Wetmelon/DifferentialSPIEncoder/Master/ODrive_Mech.PNG

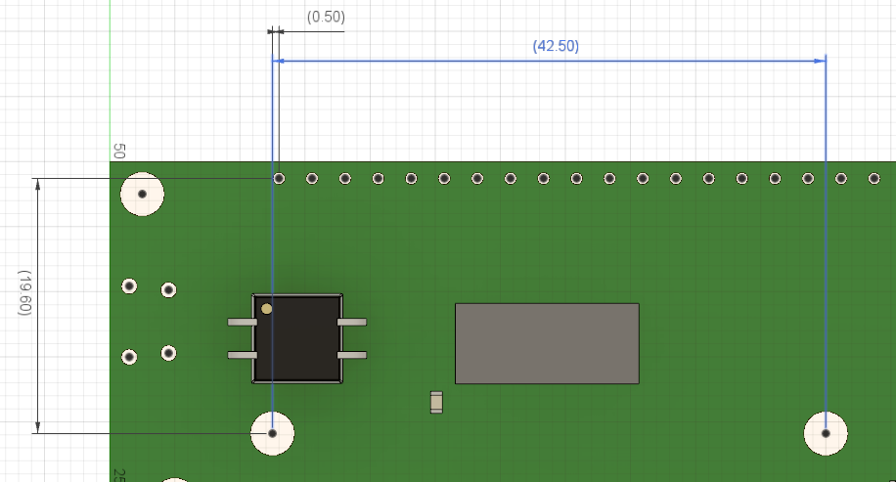
Master/ODrive_Mech.PNG
