Wetmelon/DifferentialSPIEncoder/MOUSER_BOM.xlsx

Source: | /DifferentialSPIEncoder/Master/DifferentialSPIMaster.sch
Date: | 2019
Tool: | Eeschema (5.1.4-0)
Generator: | bom_csv_grouped_by_value.py
 |  |  | MASTER
Item | Qty | Reference(s) | Value | LibPart | Footprint | Datasheet | MANUFACTURER | MFN
1 | 6 | C1, C4, C6, C7, C8, C9 | 100nF | Device:C | Capacitor_SMD:C_0805_2012Metric_Pad1.15x1.40mm_HandSolder | https://www.mouser.com/ProductDetail/KEMET/C0805C104K8RACTU | KEMET | C0805C104K8RACTU
2 | 5 | C2, C3, C5, C10, C11 | 2.2pF | Device:C | Capacitor_SMD:C_0805_2012Metric_Pad1.15x1.40mm_HandSolder | https://www.mouser.com/ProductDetail/KEMET/C0805C229C5GACTU?qs=sGAEpiMZZMs0AnBnWHyRQOf5HOpVaXbhFR3RVpI2kPg%3D | KEMET | C0805C229C5GACTU
3 | 2 | H1, H2 | MountingHole | Mechanical:MountingHole | MountingHole:MountingHole_3.5mm
4 | 2 | J1, J3 | Motor Encoder 0 | Connector:8P8C_Shielded | Connector_RJ:RJ45_Amphenol_RJHSE5380 | https://www.mouser.com/ProductDetail/Amphenol-Commercial-Products/RJHSE-5380?qs=rM3ofmSYd5RUaPrWD7oMhw%3D%3D | Amphenol Commercial Products | RJHSE5380
5 | 1 | J2 | Conn_01x20 | Connector_Generic:Conn_01x20 | Connector_PinHeader_2.54mm:PinHeader_1x20_P2.54mm_Vertical
6 | 1 | NT1 | Net-Tie_2 | Device:Net-Tie_2 | NetTie:NetTie-2_SMD_Pad0.5mm
7 | 2 | R1, R13 | 120 | Device:R_Small | Resistor_SMD:R_0805_2012Metric_Pad1.15x1.40mm_HandSolder | https://www.mouser.com/ProductDetail/Yageo/AC0805JR-07120RL?qs=sGAEpiMZZMu61qfTUdNhG2gsBIEdmNID0VVuxMUL8GE%3D | Yageo | AC0805JR-07120RL
8 | 12 | R2, R3, R4, R5, R6, R7, R8, R9, R10, R11, R12, R14 | 1k | Device:R | Resistor_SMD:R_0805_2012Metric_Pad1.15x1.40mm_HandSolder | https://www.mouser.com/ProductDetail/Yageo/AC0805FR-7W1KL | Yageo | AC0805FR-7W1KL
9 | 6 | U1, U2, U3, U4, U5, U6 | MAX485E | Interface_UART:MAX485E | Package_SO:SOIC-8_3.9x4.9mm_P1.27mm | https://www.mouser.com/ProductDetail/Maxim-Integrated/MAX485ESA%2b | Maxim Integrated | MAX485ESA+
 | 37
 |  |  | SLAVE
Item | Qty | Reference(s) | Value | LibPart | Footprint | Datasheet | MANUFACTURER | MFN
1 | 1 | C1 | 10uF | Device:C | Capacitor_SMD:C_0603_1608Metric | https://www.mouser.com/ProductDetail/KEMET/C0603C106M8PACTU | KEMET | C0603C106M8PACTU
2 | 4 | C3, C7, C8, C9 | 100nF | Device:C | Capacitor_SMD:C_0402_1005Metric | https://www.mouser.com/ProductDetail/KEMET/C0402C104K8PAC7411 | KEMET | C0402C104K8PAC7411
3 | 3 | C4, C5, C6 | 2.2pF | Device:C | Capacitor_SMD:C_0402_1005Metric | https://www.mouser.com/ProductDetail/KEMET/C0402C229C8GACTU?qs=sGAEpiMZZMs0AnBnWHyRQG8EQLxJcrqdhsIEzL7CC1E%3D | KEMET | C0402C229C8GACTU
4 | 1 | J1 | Conn_01x05_Male | Connector:Conn_01x05_Male | Connector_PinHeader_2.54mm:PinHeader_1x05_P2.54mm_Vertical
5 | 1 | J2 | 8P8C_Shielded | Connector:8P8C_Shielded | Connector_RJ:RJ45_Amphenol_RJHSE5380 | https://www.mouser.com/ProductDetail/Amphenol-Commercial-Products/RJHSE-5380?qs=rM3ofmSYd5RUaPrWD7oMhw%3D%3D |  | RJHSE5380
6 | 5 | R1, R5, R6, R7, R8 | 10k | Device:R | Resistor_SMD:R_0402_1005Metric | https://www.mouser.com/ProductDetail/Yageo/RT0402DRE0710KL | Yageo | RT0402DRE0710KL
7 | 3 | R2, R3, R4 | 1k | Device:R | Resistor_SMD:R_0402_1005Metric | https://www.mouser.com/ProductDetail/Yageo/AA0402FR-071KL | Yageo | AA0402FR-071KL
8 | 2 | R9, R10 | 120 | Device:R_Small | Resistor_SMD:R_0402_1005Metric | https://www.mouser.com/ProductDetail/Yageo/RC0402JR-07120RL | Yageo | RC0402JR-07120RL
9 | 1 | U2 | AS5048A | Sensor_Magnetic:AS5048A | Package_SO:TSSOP-14_4.4x5mm_P0.65mm | https://www.mouser.com/ProductDetail/ams/AS5048A-HTSP-500?qs=sGAEpiMZZMsDsvR9Yj%2Fex3rI8ueL6AI9 | ams | AS5048A-HTSP-500
10 | 3 | U3, U4, U5 | MAX485E | Interface_UART:MAX485E | Package_SO:SOIC-8_3.9x4.9mm_P1.27mm | https://www.mouser.com/ProductDetail/Maxim-Integrated/MAX485ESA%2b |  | MAX485ESA+
 | 24
