Wetmelon/DifferentialSPIEncoder/Slave/3dmodels/SM02B-GHS-TB.STEP

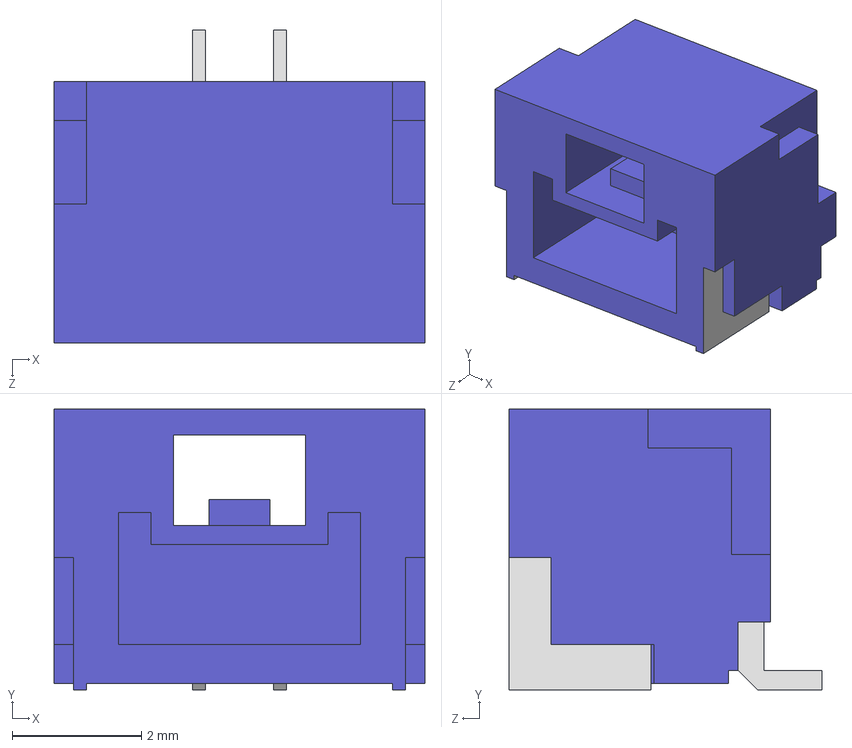
[picture p2: CAD file, 2022-04-24]
Slave/3dmodels/SM02B-GHS-TB.STEP
5.75 x 4.35 x 4.85 mm
