Wetmelon/DifferentialSPIEncoder/Slave/DifferentialEncoderSlave.step

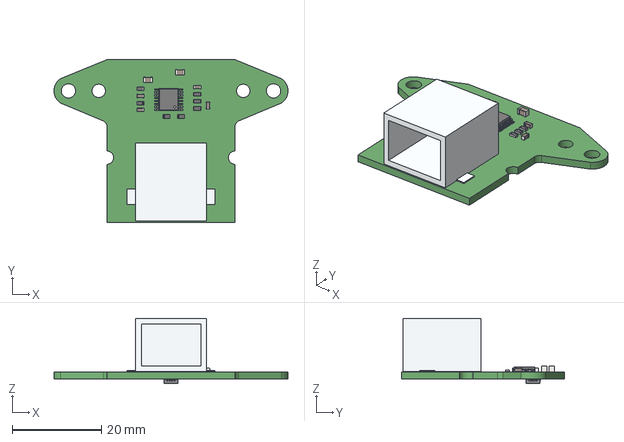
[picture p3: CAD file, 2020-12-17]
Slave/DifferentialEncoderSlave.step
52.5 x 36.5 x 14.6 mm
