Wetmelon/DifferentialSPIEncoder/Slave/RJLSE4x1xx.STEP

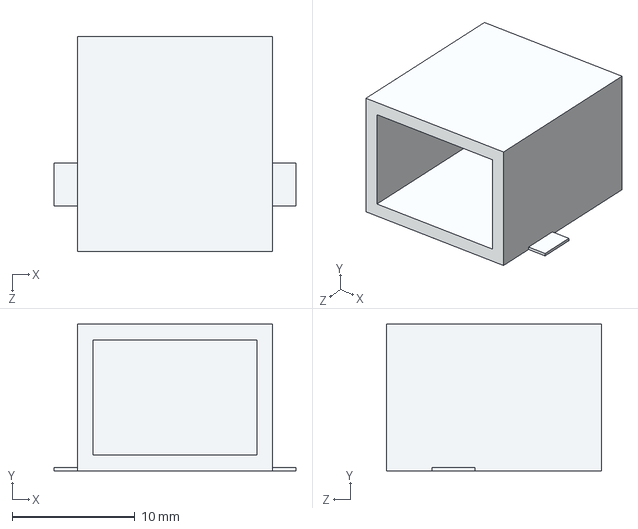
[picture p4: CAD file, 2020-12-06]
Slave/RJLSE4x1xx.STEP
19.7 x 11.9 x 17.5 mm
