Wetmelon/DifferentialSPIEncoder/Slave/3dmodels/5025850670.stp

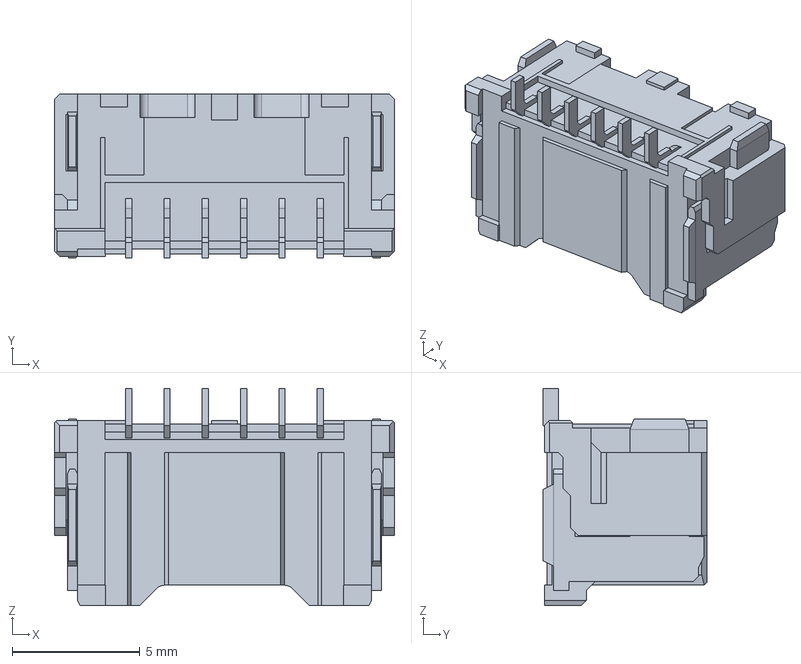
[picture p5: CAD file, 2022-04-24]
Slave/3dmodels/5025850670.stp
13.3 x 6.40 x 8.50 mm
