Wetmelon/DifferentialSPIEncoder/(list of files, cad)

Other CAD files:
Slave/RJLSE4x1xx.SLDPRT
Slave/Solidworks/DifferentialEncoderSlave.SLDASM
