Wetmelon/DifferentialSPIEncoder/(threads)

Thread 1 (2019-11-26):

Recommendation: label top of master with pin names of odrive board

owhite, 2019-11-26:
...because the master gets stuck on top of the odrive, it's hard to read the already difficult to read pin names of the odrive header. Labels on the master would be helpful in next version.

Thread 2 (2019-12-02):

Changes for Rev 2

Wetmelon, 2019-12-02:
- [ ] Connect PWM to debug header
- [ ] Use RJ45 LEDs for pwr & etc
- [ ] Termination resistor on both ends, not just 1 end
- [ ] Add pullup resistor to CS
- [ ] General CS handling logic review
- [ ] Disconnect pins 6-10 on AS5048A, leave pin 5 on GND
- [ ] Add AMT102 "Wide" compatible holes
- [ ] Add debug output on slave header for MOSI
- [ ] 10MHz transceivers
