Wetmelon/DifferentialSPIEncoder/Master/DifferentialEncoderMaster.pdf

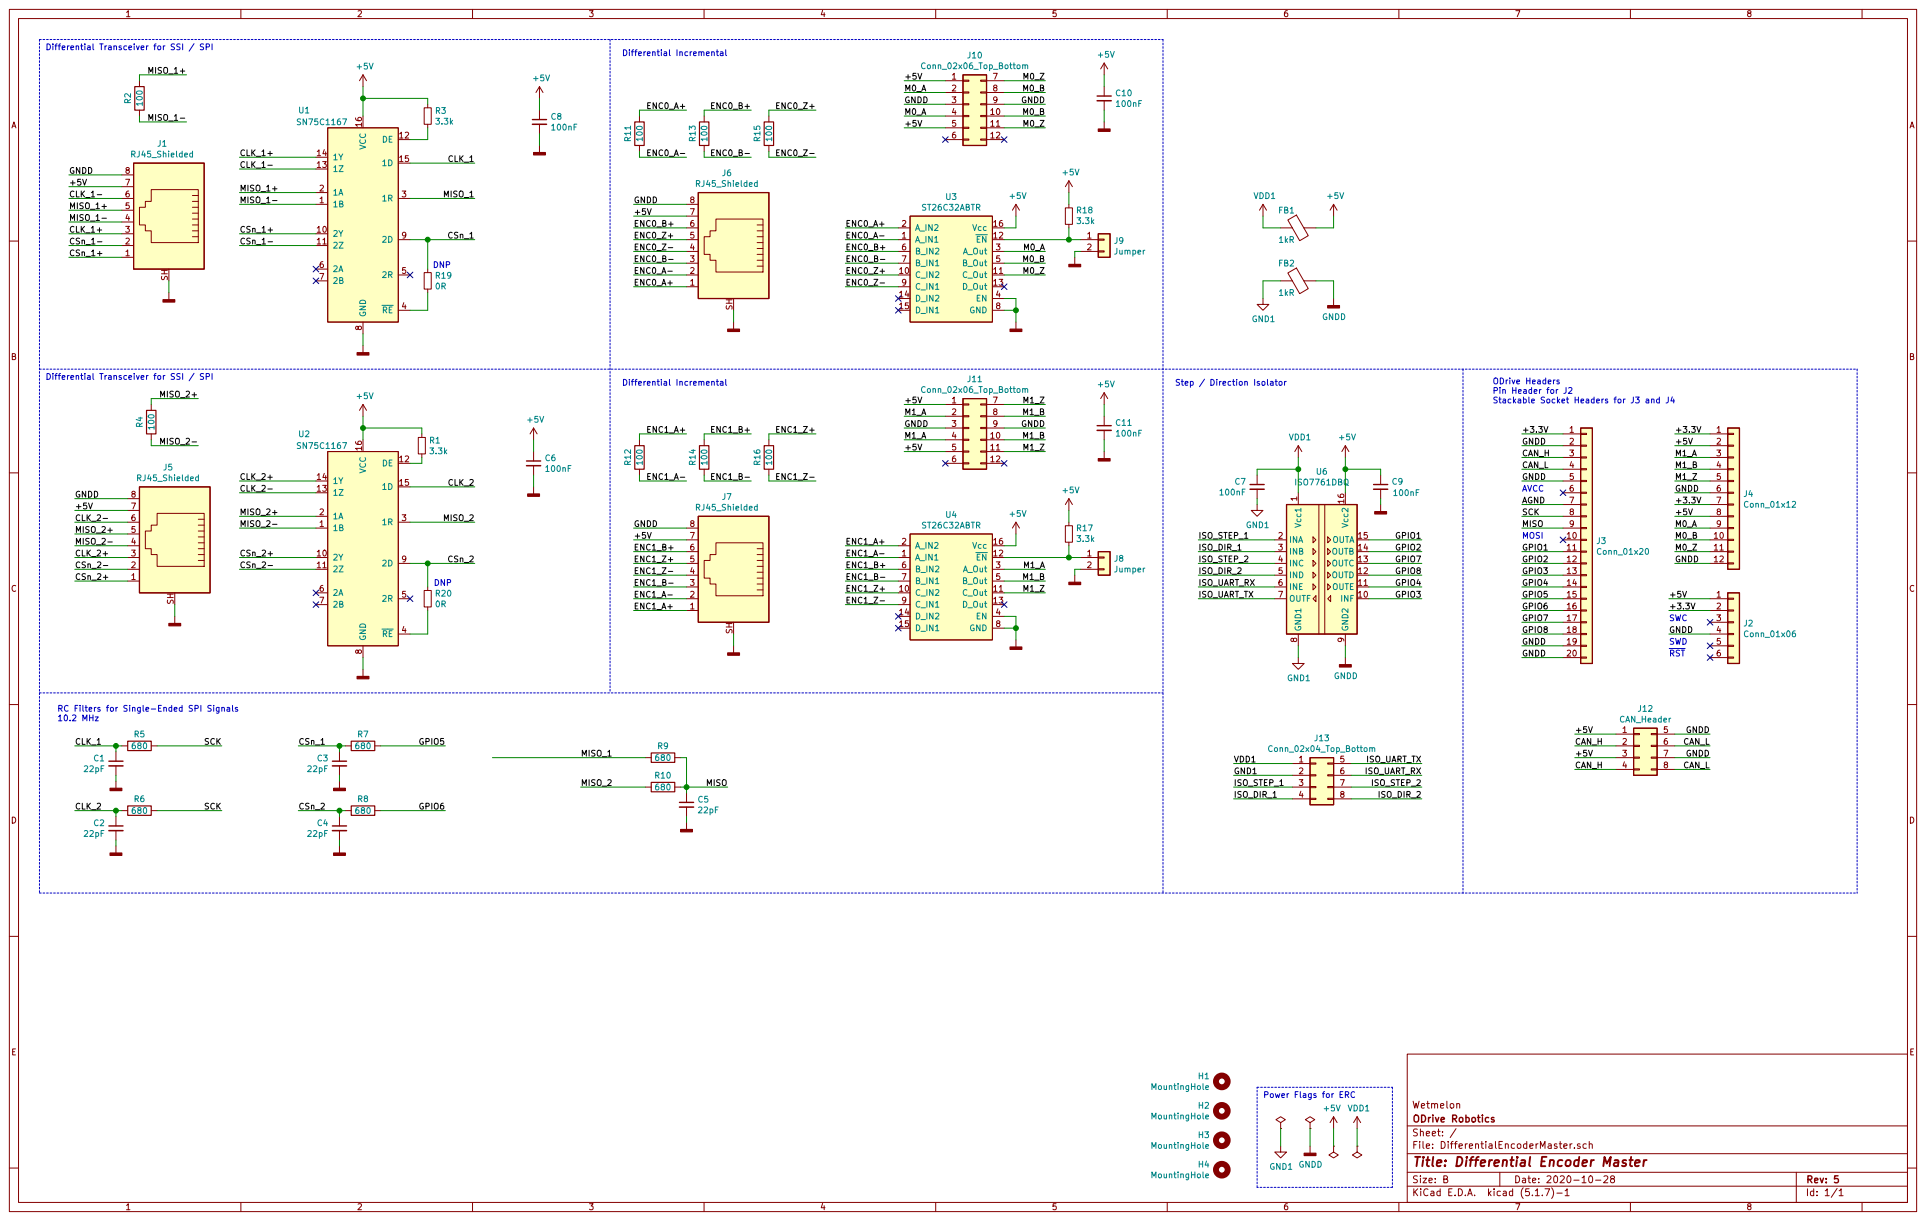
[picture p6: page 1]

Power Flags for ERC
VDD1 GND1

Id: 1/1 Title: Differential Encoder Master File: DifferentialEncoderMaster.sch Sheet: / ODrive Robotics Wetmelon
