Wetmelon/DifferentialSPIEncoder/Master/Isolated DifferentialEncoderMaster.pdf

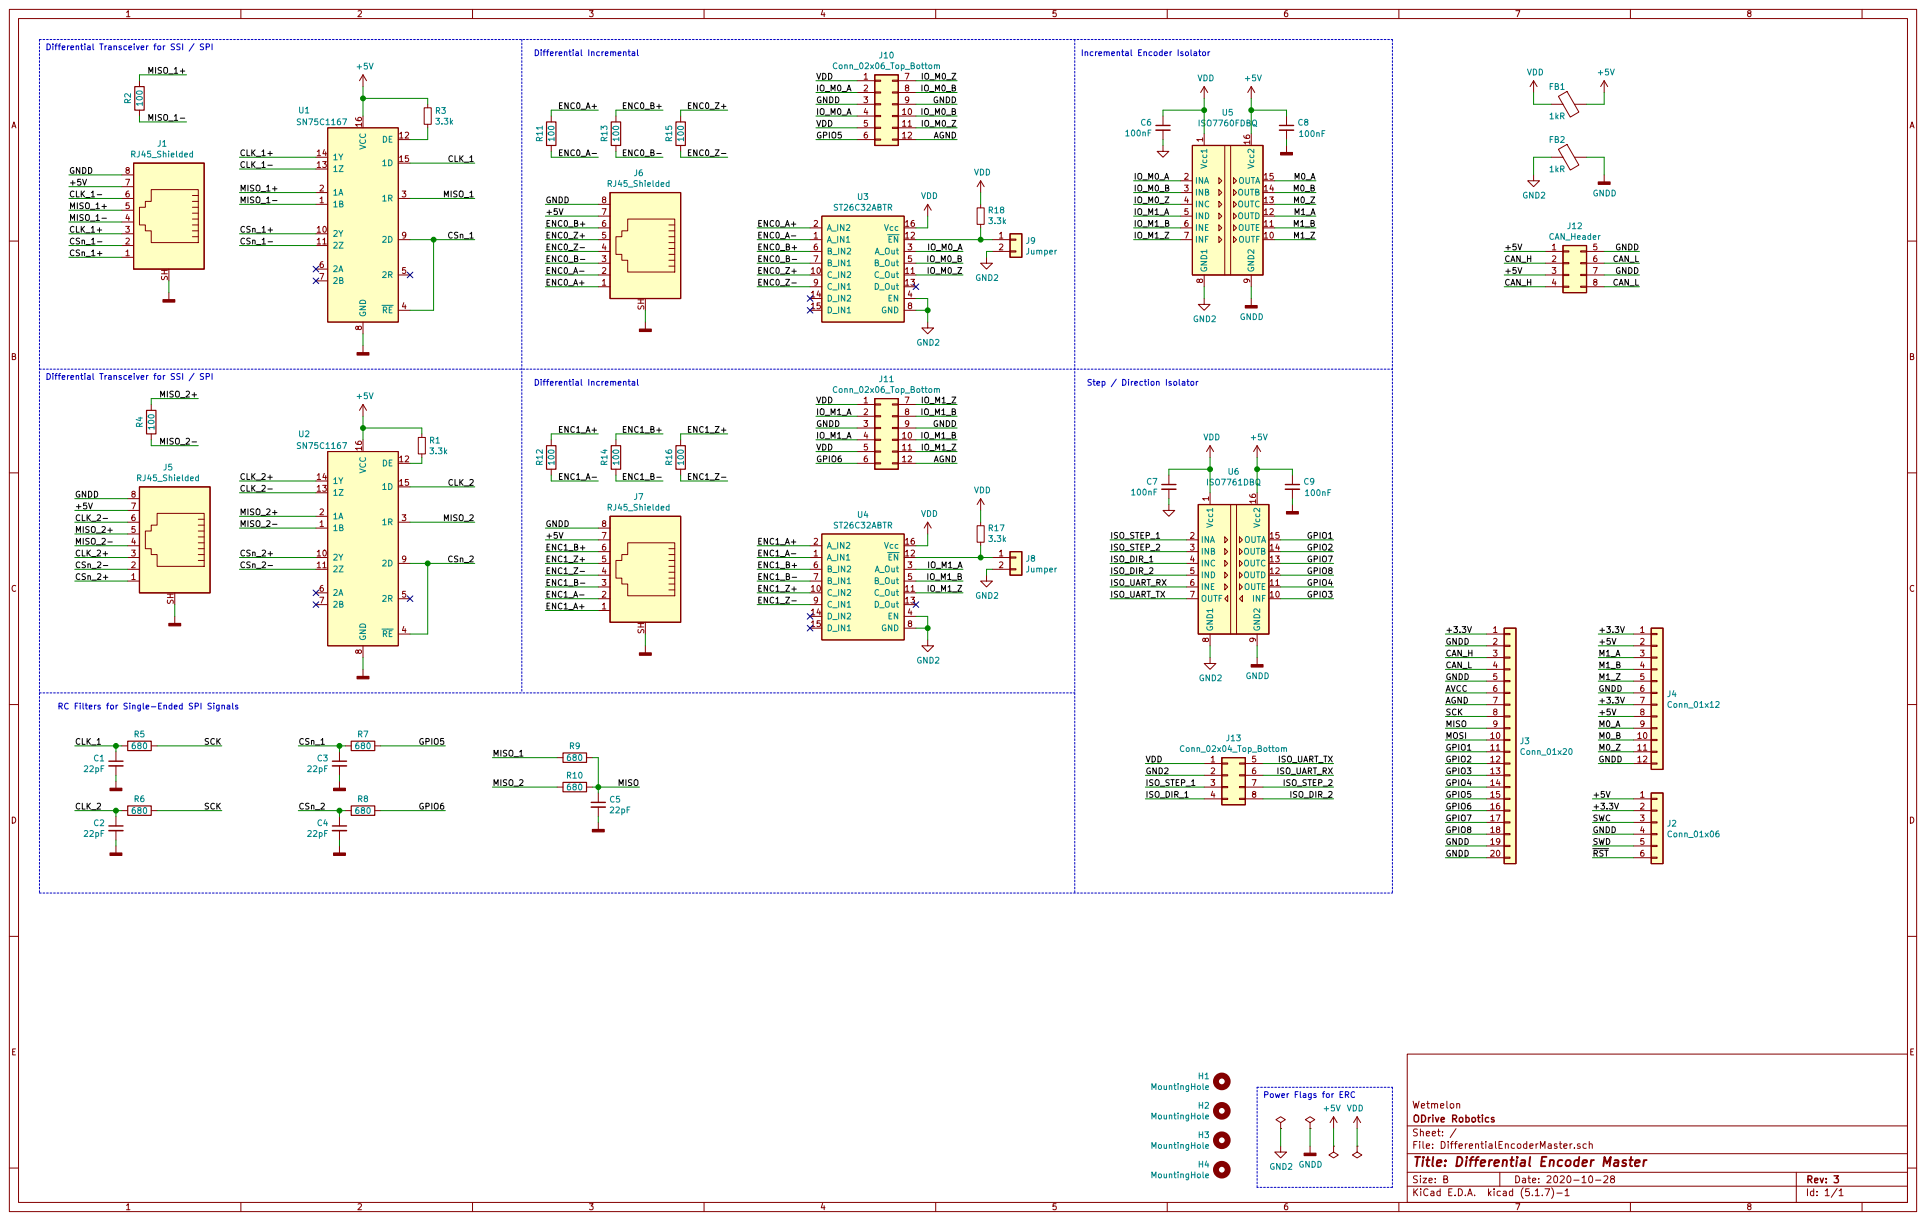
[picture p7: page 1]

1 OUTF 10 OUTE 11 OUTD 12 OUTC 13 OUTB 14 OUTA 15 Vcc2 16

RC Filters for Single-Ended SPI Signals

ISO_UART_RX 6 | GPIO2 GPIO3 GPIO4 13

7 ISO_STEP_2 | 14
8 | 15

Power Flags for ERC
