Wetmelon/DifferentialSPIEncoder/Slave/DifferentialEncoderSlave.pdf

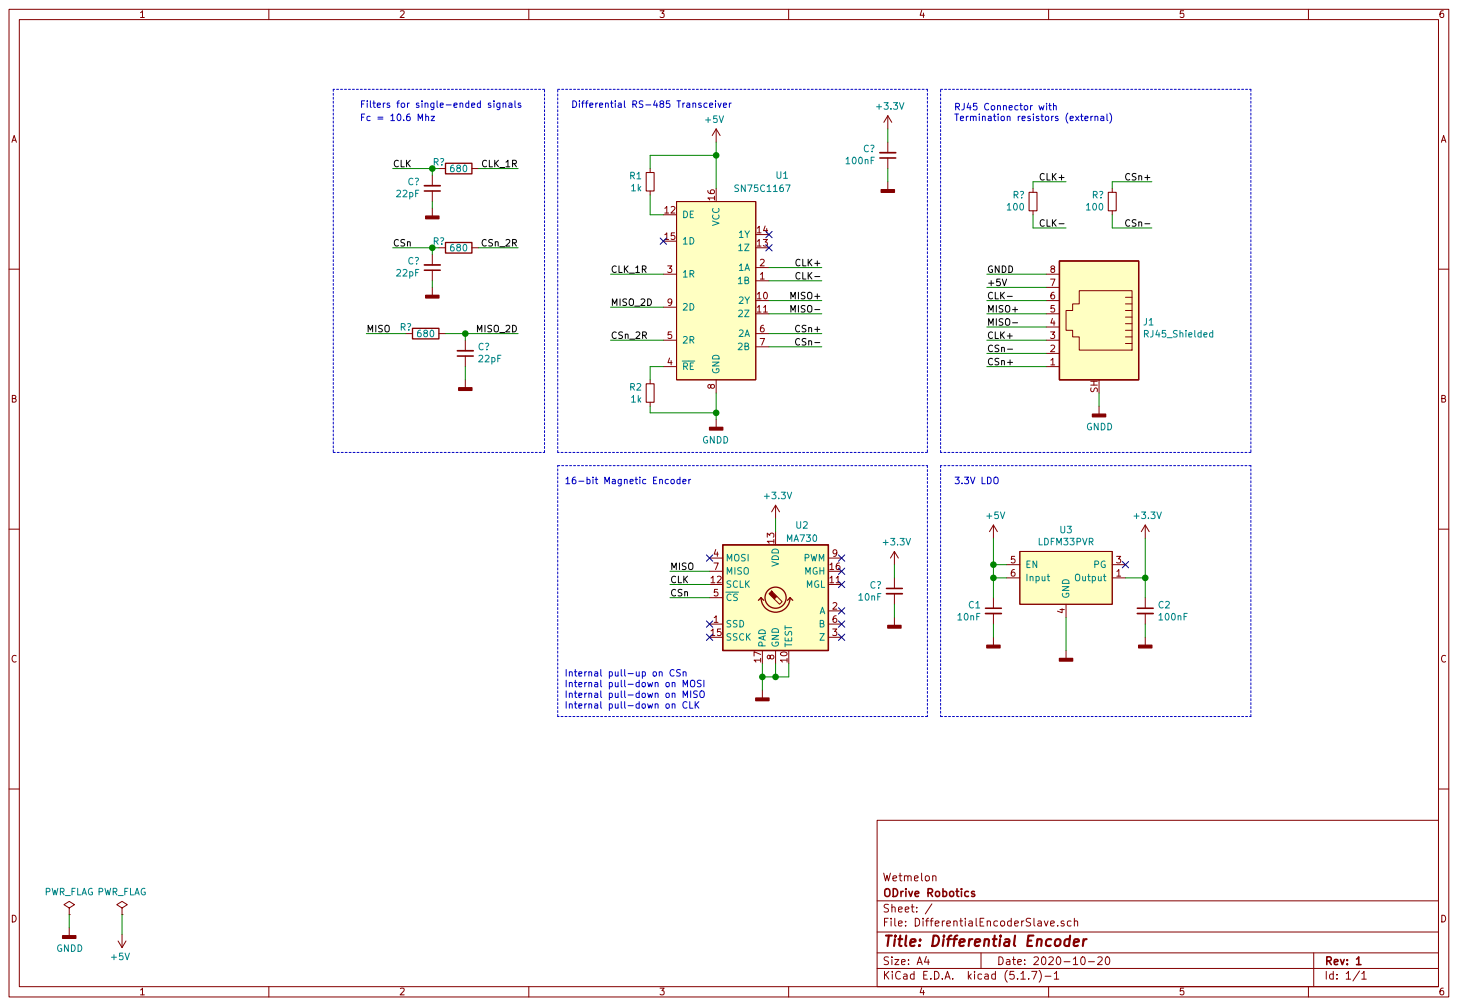
[picture p8: page 1]

RJ45 Connector with Termination resistors (external) Differential RS-485 Transceiver 16-bit Magnetic Encoder

CLK+ CLK- CSn+ CSn- MISO

Internal pull-up on CSn
Internal pull-down on MOSI
Internal pull-down on MISO
Internal pull-down on CLK

Id: 1/1 Title: Differential Encoder File: DifferentialEncoderSlave.sch Sheet: / ODrive Robotics Wetmelon
