Wetmelon/DifferentialSPIEncoder/Slave/DifferentialEncoderSlave.kicad_pcb

## KiCad design Slave/DifferentialEncoderSlave.kicad_pcb (2022-04-25)

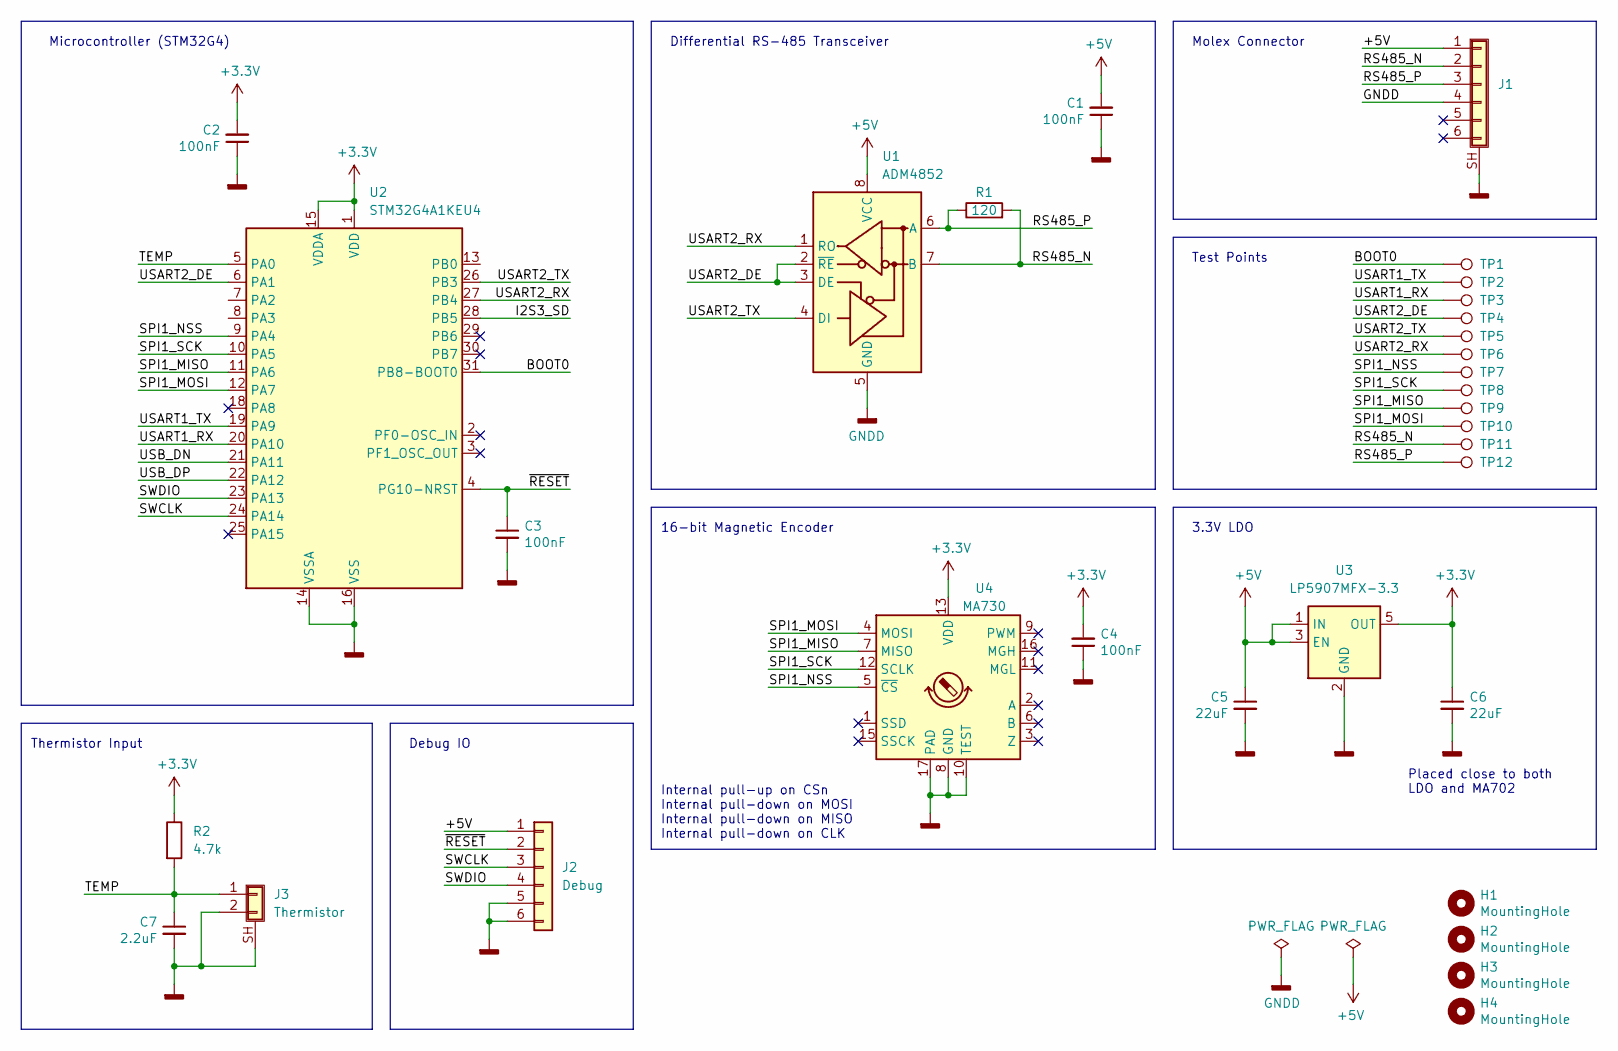
[picture p9: schematic DifferentialEncoderSlave.kicad_sch, Differential Encoder]

Parts:
C1, C2, C3, C4: 100nF; C_0402_1005Metric
C5, C6: 22uF; C_0805_2012Metric
C7: 2.2uF; C_0402_1005Metric
H1, H2, H3, H4: MountingHole; MountingHole_3mm
J1: (no value)
J2: Debug; Tag-Connect_TC2030-IDC-NL_2x03_P1.27mm_Vertical
J3: Thermistor; JST_GH_SM02B
R1: 120; R_0402_1005Metric
R2: 4.7k; R_0402_1005Metric
TP1, TP2, TP3, TP4, TP5, TP6, TP7, TP8, TP9, TP10, TP11, TP12: TestPoint; TestPoint_Pad_D1.0mm
U1: ADM4852; LFCSP-8-1EP_3x3mm_P0.5mm_EP1.45x1.74mm
U2: STM32G4A1KEU4; UFQFPN-32-1EP_5x5mm_P0.5mm_EP3.5x3.5mm
U3: LP5907MFX-3.3; SOT-23-5
U4: MA730; QFN-16-1EP_3x3mm_P0.5mm_EP1.7x1.7mm

Connections:
+3V3: C2.2, C4.2, C6.1, R2.1, U2.1 (VDD), U2.15 (VDDA), U2.17 (VDD), U3.5 (OUT), U4.13 (VDD)
+5V: C1.2, C5.1, J1.1, J2.1, U1.8 (VCC), U3.1 (IN), U3.3 (EN)
/BOOT0: TP1.1, U2.31 (PB8-BOOT0)
/I2S3_SD: U2.28 (PB5)
/RS485_N: J1.2, R1.2, TP11.1, U1.7 (B)
/RS485_P: J1.3, R1.1, TP12.1, U1.6 (A)
/SPI1_MISO: TP9.1, U2.11 (PA6), U4.7 (MISO)
/SPI1_MOSI: TP10.1, U2.12 (PA7), U4.4 (MOSI)
/SPI1_NSS: TP7.1, U2.9 (PA4), U4.5 (~CS)
/SPI1_SCK: TP8.1, U2.10 (PA5), U4.12 (SCLK)
/SWCLK: J2.3, U2.24 (PA14)
/SWDIO: J2.4, U2.23 (PA13)
/TEMP: C7.1, J3.1, R2.2, U2.5 (PA0)
/USART1_RX: TP3.1, U2.20 (PA10)
/USART1_TX: TP2.1, U2.19 (PA9)
/USART2_DE: TP4.1, U1.2 (~RE), U1.3 (DE), U2.6 (PA1)
/USART2_RX: TP6.1, U1.1 (RO), U2.27 (PB4)
/USART2_TX: TP5.1, U1.4 (DI), U2.26 (PB3)
/USB_DN: U2.21 (PA11)
/USB_DP: U2.22 (PA12)
/~RESET: C3.1, J2.2, U2.4 (PG10-NRST)
GNDD: C1.1, C2.1, C3.2, C4.1, C5.2, C6.2, C7.2, J1.4, J1.SH (Shield), J2.5, J2.6, J3.2, J3.SH (Shield), U1.5 (GND), U1.PAD, U2.14 (VSSA), U2.16 (VSS), U2.32 (VSS), U2.33 (PAD), U3.2 (GND), U4.8 (GND), U4.10 (TEST), U4.17 (PAD)

Notes on the sheet:
Test Points
Thermistor Input
Internal pull-up on CSn Internal pull-down on MOSI Internal pull-down on MISO Internal pull-down on CLK
16-bit Magnetic Encoder
Placed close to both LDO and MA702
3.3V LDO
Differential RS-485 Transceiver
Microcontroller (STM32G4)
Molex Connector
Debug IO

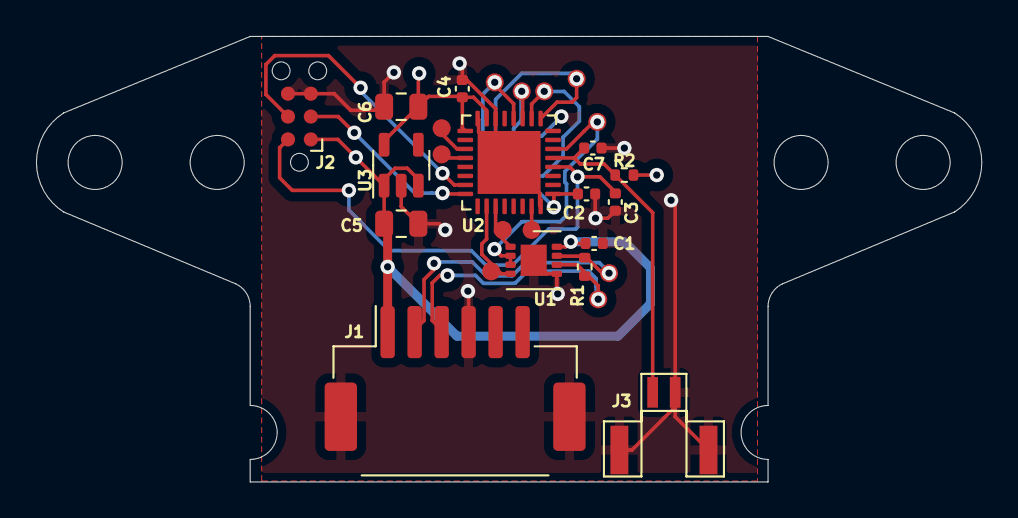
[picture p10: board DifferentialEncoderSlave.kicad_pcb from above]

Board: 4 copper layers, 52.5 x 24.8 mm, 32 parts (1 on the bottom side), 19 nets.
