Wetmelon/DifferentialSPIEncoder/Master/DifferentialEncoderMaster.kicad_pcb

## KiCad design Master/DifferentialEncoderMaster.kicad_pcb (2021-04-08)

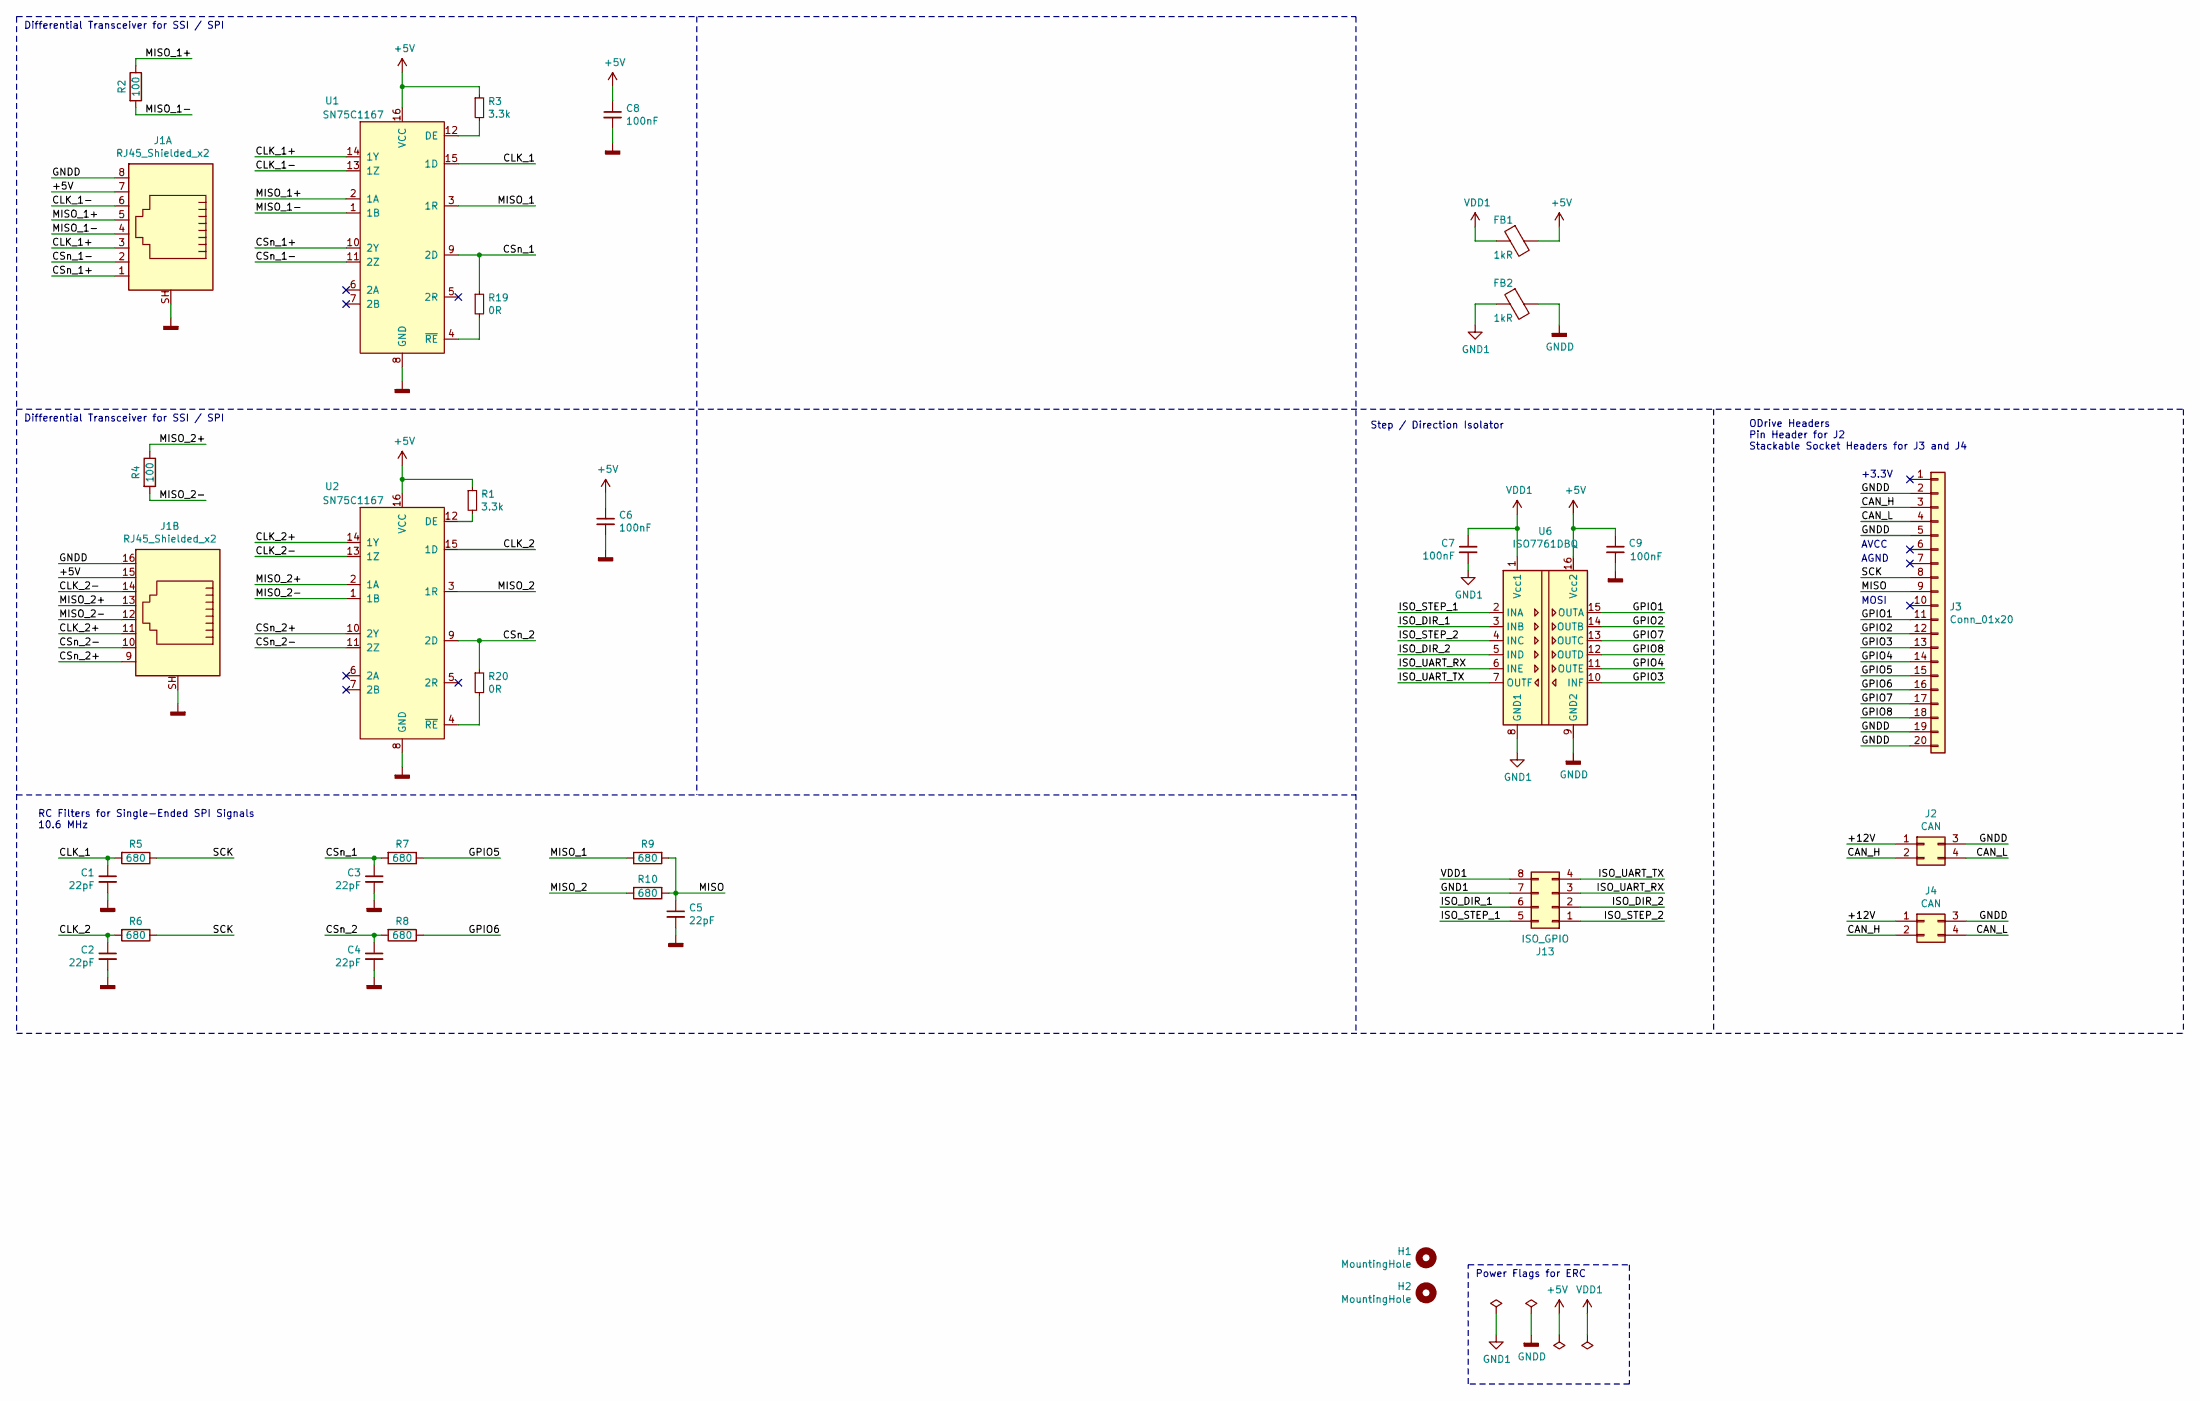
[picture p11: schematic DifferentialEncoderMaster.sch, Differential Encoder Master]

Parts:
C1, C2, C3, C4, C5: 22pF; C_0603_1608Metric
C6, C7, C8, C9: 100nF; C_0603_1608Metric
FB1, FB2: 1kR; L_0603_1608Metric
H1, H2: MountingHole; MountingHole_3.2mm_M3
J1: RJ45_Shielded_x2; RJ45_RJSSE5380-02
J2, J4: CAN; Molex_Nano-Fit_105310-xx04_2x02_P2.50mm_Vertical
J3: Conn_01x20; PinSocket_1x20_P2.54mm_Vertical
J13: ISO_GPIO; Molex_Nano-Fit_105310-xx08_2x04_P2.50mm_Vertical
R1, R3: 3.3k; R_0603_1608Metric
R2, R4: 100; R_0603_1608Metric
R5, R6, R7, R8, R9, R10: 680; R_0603_1608Metric
R19, R20: 0R; R_0603_1608Metric
U1, U2: SN75C1167; SSOP-16_5.3x6.2mm_P0.65mm
U6: ISO7761DBQ; SSOP-16_3.9x4.9mm_P0.635mm

Connections:
+5V: C6.1, C8.1, C9.1, FB1.2, J1.7, J1.15, R1.1, R3.1, U1.16 (VCC), U2.16 (VCC), U6.16 (Vcc2)
/+12V: J2.1, J4.1
/CAN_H: J2.2, J3.3, J4.2
/CAN_L: J2.4, J3.4, J4.4
/CLK_1: C1.1, R5.2, U1.15 (1D)
/CLK_1+: J1.3, U1.14 (1Y)
/CLK_1-: J1.6, U1.13 (1Z)
/CLK_2: C2.1, R6.2, U2.15 (1D)
/CLK_2+: J1.11, U2.14 (1Y)
/CLK_2-: J1.14, U2.13 (1Z)
/CSn_1: C3.1, R7.2, R19.1, U1.9 (2D)
/CSn_1+: J1.1, U1.10 (2Y)
/CSn_1-: J1.2, U1.11 (2Z)
/CSn_2: C4.1, R8.2, R20.1, U2.9 (2D)
/CSn_2+: J1.9, U2.10 (2Y)
/CSn_2-: J1.10, U2.11 (2Z)
/GPIO1: J3.11, U6.15 (OUTA)
/GPIO2: J3.12, U6.14 (OUTB)
/GPIO3: J3.13, U6.10 (INF)
/GPIO4: J3.14, U6.11 (OUTE)
/GPIO5: J3.15, R7.1
/GPIO6: J3.16, R8.1
/GPIO7: J3.17, U6.13 (OUTC)
/GPIO8: J3.18, U6.12 (OUTD)
/ISO_DIR_1: J13.6, U6.3 (INB)
/ISO_DIR_2: J13.2, U6.5 (IND)
/ISO_STEP_1: J13.5, U6.2 (INA)
/ISO_STEP_2: J13.1, U6.4 (INC)
/ISO_UART_RX: J13.3, U6.6 (INE)
/ISO_UART_TX: J13.4, U6.7 (OUTF)
/MISO: C5.1, J3.9, R9.2, R10.2
/MISO_1: R9.1, U1.3 (1R)
/MISO_1+: J1.5, R2.1, U1.2 (1A)
/MISO_1-: J1.4, R2.2, U1.1 (1B)
/MISO_2: R10.1, U2.3 (1R)
/MISO_2+: J1.13, R4.1, U2.2 (1A)
/MISO_2-: J1.12, R4.2, U2.1 (1B)
/SCK: J3.8, R5.1, R6.1
GND1: C7.2, FB2.1, J13.7, U6.8 (GND1)
GNDD: C1.2, C2.2, C3.2, C4.2, C5.2, C6.2, C8.2, C9.2, FB2.2, J1.8, J1.16, J1.SH, J2.3, J3.2, J3.5, J3.19, J3.20, J4.3, U1.8 (GND), U2.8 (GND), U6.9 (GND2)
unnamed: R1.2, U2.12 (DE)
unnamed: R3.2, U1.12 (DE)
unnamed: R19.2, U1.4 (~RE)
unnamed: R20.2, U2.4 (~RE)
VDD1: C7.1, FB1.1, J13.8, U6.1 (Vcc1)

Notes on the sheet:
Differential Transceiver for SSI / SPI
RC Filters for Single-Ended SPI Signals 10.6 MHz
Power Flags for ERC
ODrive Headers Pin Header for J2 Stackable Socket Headers for J3 and J4
MOSI
AVCC
AGND
+3.3V
Step / Direction Isolator

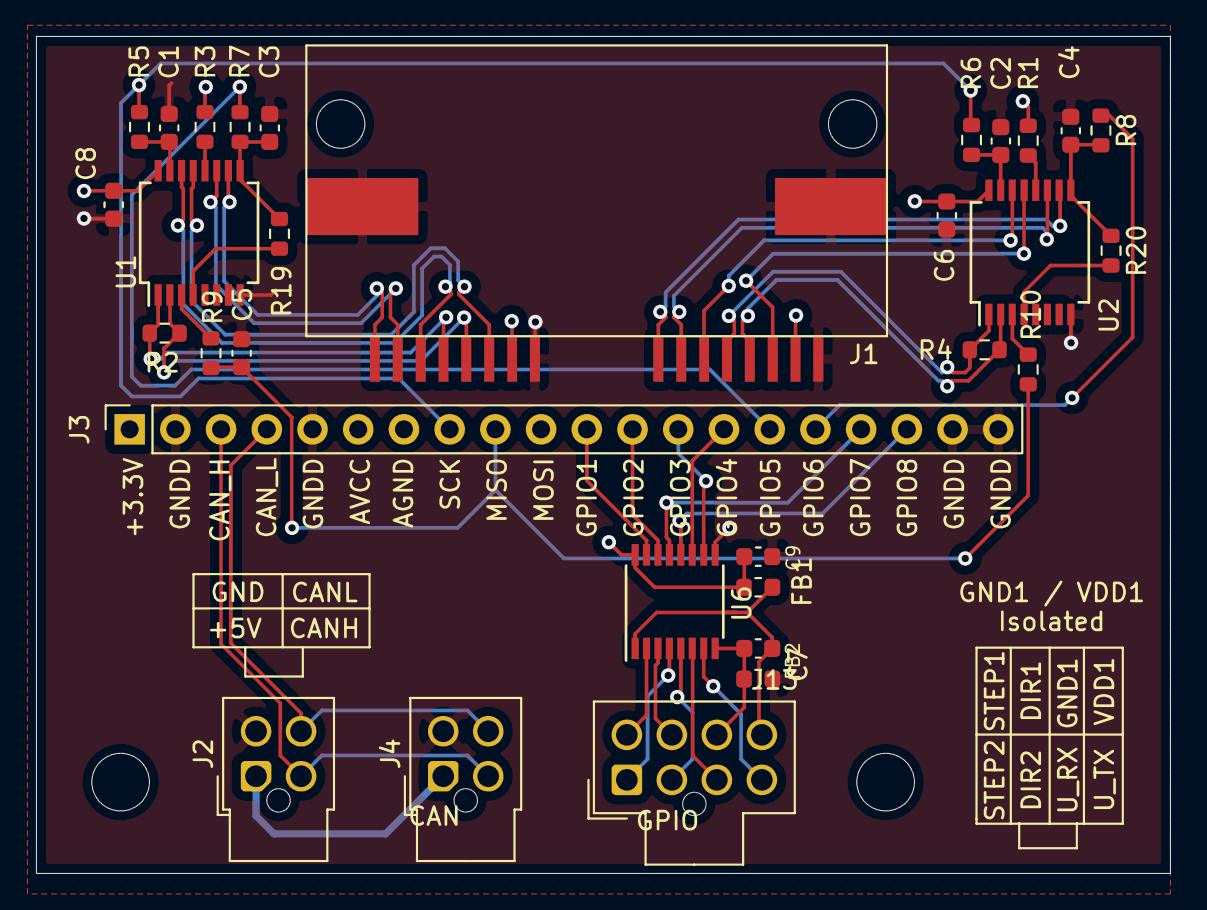
[picture p12: board DifferentialEncoderMaster.kicad_pcb from above]

Board: 4 copper layers, 63.0 x 46.5 mm, 33 parts (0 on the bottom side), 45 nets.
