Wetmelon/DifferentialSPIEncoder/(commit log)

2019-06-01 Fix voltage pins on Master
2019-06-06 Add LPFs to single-ended signals
    [DifferentialSPIEncoder.sch, DifferentialSPIMaster.sch]
2019-06-09 Start laying out Master
    [DifferentialSPIEncoder.kicad_pcb, DifferentialSPIEncoder.sch, DifferentialSPIMaster.sch]
2019-10-13 CS transceivers now correctly setup to transmit, not receive
    [DifferentialSPIMaster.kicad_pcb]
2019-10-14 new stuff
    [DifferentialSPIEncoder-B_Paste.dxf, DifferentialSPIEncoder-B_SilkS.dxf, DifferentialSPIEncoder-Edge_Cuts.dxf, DifferentialSPIEncoder-F_Paste.dxf, DifferentialSPIEncoder-F_SilkS.dxf, DifferentialSPIEncoder.kicad_pcb, Untitled.3dm, thing.dxf]
2019-10-14 nother commit
    [DifferentialSPIEncoder.kicad_pcb]
2019-10-14 next version
    [DifferentialSPIEncoder.kicad_pcb]
2019-10-15 fixed mounting holes
    [DifferentialSPIEncoder.kicad_pcb]
2019-10-18 converted to +5v only
    [DifferentialSPIEncoder.kicad_pcb, DifferentialSPIEncoder.sch, thing.dxf]
2019-10-20 Shame. Shame. Shame.
    [DifferentialSPIEncoder.sch]
2019-10-21 CLK is an output, not an input on master, also add edge cuts layer
    [DifferentialSPIMaster.kicad_pcb, DifferentialSPIMaster.sch]
2019-10-21 Fix silkscreen
    [DifferentialSPIMaster.kicad_pcb]
2019-10-21 Move board edge closer to RJ45s
    [DifferentialSPIMaster.kicad_pcb]
2019-10-26 Add top/bottom fills, make board 2 layer
    [DifferentialSPIMaster.kicad_pcb]
2019-11-02 added gerbers
    [DifferentialSPIEncoder-B_Cu.gbr, DifferentialSPIEncoder-B_Mask.gbr, DifferentialSPIEncoder-B_Paste.gbr, DifferentialSPIEncoder-B_SilkS.gbr, DifferentialSPIEncoder-Edge_Cuts.gbr, DifferentialSPIEncoder-F_Cu.gbr, DifferentialSPIEncoder-F_Mask.gbr, DifferentialSPIEncoder-F_Paste.gbr]
2019-11-07 Added values for LPFs
    [DifferentialSPIEncoder.sch, DifferentialSPIMaster.sch]
2019-11-07 add BOM for parts
    [DifferentialSPIEncoder.csv, DifferentialSPIEncoder.sch, DifferentialSPIMaster.csv, DifferentialSPIMaster.sch, MOUSER_BOM.xlsx]
2019-12-02 Update master schematic with changes from #2
    [DifferentialSPIMaster.sch]
2019-12-02 Update slave schematic with changes from #2
    [DifferentialSPIEncoder.kicad_pcb, DifferentialSPIEncoder.sch]
2019-12-02 Replace MAX485E with SN65HVD06D for 10mbps signaling
    [DifferentialSPIEncoder.sch, DifferentialSPIMaster.sch]
2019-12-02 Fit slave to AMT102 footprint
    [DifferentialSPIEncoder.kicad_pcb, DifferentialSPIEncoder.sch]
2019-12-02 Finish slave layout
    [DifferentialSPIEncoder.kicad_pcb, DifferentialSPIEncoder.sch]
2019-12-02 Tweaks to layout to better fit AMT footprint
    [DifferentialSPIEncoder.kicad_pcb, DifferentialSPIEncoder.sch]
2019-12-02 Add silkscreen with info
    [DifferentialSPIEncoder.kicad_pcb, DifferentialSPIEncoder.sch]
2019-12-03 Move copper pours inboard to avoid screw heads
    [DifferentialSPIEncoder.kicad_pcb]
2019-12-03 Swap AS5048A with AS5047U
    [DifferentialSPIEncoder.kicad_pcb, DifferentialSPIEncoder.sch]
2019-12-03 Some tweaks
    [DifferentialSPIEncoder.sch]
2019-12-05 Add pullups for CS lines and remove extra material from master
    [DifferentialSPIMaster.kicad_pcb, DifferentialSPIMaster.sch]
2019-12-05 differential tuning on master
    [DifferentialSPIMaster.kicad_pcb]
2020-07-22 Swap to MAX14783E
    [DifferentialSPIEncoder.sch, DifferentialSPIMaster.sch]
2020-07-22 Update PCB
    [DifferentialSPIEncoder.kicad_pcb]
2020-07-22 Swap to MAX14783 on Master
    [DifferentialSPIMaster.kicad_pcb, DifferentialSPIMaster.sch]
2020-10-04 Update master
    [DifferentialSPIMaster.kicad_pcb, DifferentialSPIMaster.kicad_sch, DifferentialSPIMaster.sch, file5F6495EF.sch]
2020-10-04 re-save under nightly
    [DifferentialSPIMaster.kicad_sch]
2020-10-04 remove .dxfs
    [DifferentialSPIEncoder-B_Paste.dxf, DifferentialSPIEncoder-B_SilkS.dxf, DifferentialSPIEncoder-Edge_Cuts.dxf, DifferentialSPIEncoder-F_Paste.dxf, DifferentialSPIEncoder-F_SilkS.dxf, thing.dxf]
2020-10-04 Remove gerbers
    [DifferentialSPIEncoder-B_Cu.gbr, DifferentialSPIEncoder-B_Mask.gbr, DifferentialSPIEncoder-B_Paste.gbr, DifferentialSPIEncoder-B_SilkS.gbr, DifferentialSPIEncoder-Edge_Cuts.gbr, DifferentialSPIEncoder-F_Cu.gbr, DifferentialSPIEncoder-F_Mask.gbr, DifferentialSPIEncoder-F_Paste.gbr]
2020-10-04 Fix Slave
    [DifferentialSPIEncoder.kicad_pcb, DifferentialSPIEncoder.kicad_sch, DifferentialSPIMaster.kicad_sch]
2020-10-04 Revert to older build of Kicad
    [DifferentialSPIEncoder.kicad_sch, DifferentialSPIMaster.kicad_sch]
2020-10-04 Revert slave pcb to older build of Kicad
    [DifferentialSPIEncoder.kicad_pcb]
2020-10-04 Finish encoder side layout
    [DifferentialSPIEncoder.kicad_pcb, DifferentialSPIEncoder.kicad_sch]
2020-10-23 restart Master side layout in older kicad version
    [DifferentialEncoderMaster.kicad_pcb, DifferentialEncoderMaster.sch, DifferentialEncoderSlave.kicad_pcb, DifferentialEncoderSlave.sch, DifferentialSPIEncoder.csv, DifferentialSPIEncoder.kicad_pcb, DifferentialSPIEncoder.kicad_sch, DifferentialSPIEncoder.sch]
2020-10-27 Make ODrive side full board length, add diff. incremental
    [DifferentialEncoderMaster.kicad_pcb, DifferentialEncoderMaster.sch]
2020-10-27 Minor change to encoder transceiver
    [DifferentialEncoderSlave.sch]
2020-10-28 Add digital isolators
    [DifferentialEncoderMaster.kicad_pcb, DifferentialEncoderMaster.sch]
2020-11-09 Big updates to master
    [DifferentialEncoderMaster.kicad_pcb, DifferentialEncoderMaster.sch]
2020-11-09 Finish rev 1 layout
    [DifferentialEncoderMaster.kicad_pcb, DifferentialEncoderMaster.sch]
2020-11-09 Rotate board and recreate planes
    [DifferentialEncoderMaster.kicad_pcb]
2020-11-09 Minor changes to silkscreen etc
    [DifferentialEncoderMaster.kicad_pcb]
2020-12-05 Update Slave
    [DifferentialEncoderSlave.SLDASM, DifferentialEncoderSlave.kicad_pcb, DifferentialEncoderSlave.sch, DifferentialEncoderSlave.step]
2020-12-05 Minor chagnes
    [DifferentialEncoderSlave.kicad_pcb]
2020-12-06 Update board outline
    [DifferentialEncoderSlave.kicad_pcb, DifferentialEncoderSlave.sch, DifferentialEncoderSlave.step]
2020-12-06 Use 3mm holes
    [DifferentialEncoderSlave.kicad_pcb, DifferentialEncoderSlave.sch, DifferentialEncoderSlave.step]
2020-12-06 Update Slave with circular keepout, SMD RJ 45
    [DifferentialEncoderSlave.kicad_pcb, DifferentialEncoderSlave.sch, DifferentialEncoderSlave.step, RJLSE4x1xx.SLDPRT, RJLSE4x1xx.STEP]
2020-12-06 Make the body narrower
    [DifferentialEncoderSlave.kicad_pcb]
2020-12-17 Export master BOM
    [DifferentialEncoderMaster.csv, DifferentialEncoderSlave.kicad_pcb, DifferentialEncoderSlave.sch]
2020-12-17 Make the encoder 1.3mm shorter to make it flush with the case
    [DifferentialEncoderSlave.csv, DifferentialEncoderSlave.kicad_pcb, DifferentialEncoderSlave.step]
2021-04-08 Encoder side TSSOP -> SOP 5.3x6.2
    [DifferentialEncoderSlave.kicad_pcb, DifferentialEncoderSlave.sch]
2021-04-08 Odrive side TSSOP->SSOP
    [DifferentialEncoderMaster.kicad_pcb, DifferentialEncoderMaster.sch]
2021-04-08 Remove differential encoder half
    [DifferentialEncoderMaster.kicad_pcb, DifferentialEncoderMaster.sch]
2021-04-08 Optimize layout - remove ~ 15% of vias
    [DifferentialEncoderMaster.kicad_pcb, DifferentialEncoderMaster.sch]
2021-04-08 Further layout optimization
    [DifferentialEncoderMaster.kicad_pcb]
2021-04-08 Prettify CAN wires
    [DifferentialEncoderMaster.kicad_pcb]
2022-04-17 Start RS485 revision
    [DifferentialEncoderSlave.kicad_pcb, DifferentialEncoderSlave.kicad_sch]
2022-04-18 Finish laying out encoder board
    [DifferentialEncoderSlave.kicad_pcb, DifferentialEncoderSlave.kicad_sch]
2022-04-24 Change pinout on STM32G4, add thermistor header, add test points
    [5025850670.stp, DifferentialEncoderSlave.kicad_pcb, DifferentialEncoderSlave.kicad_sch, SM02B-GHS-TB.STEP]
2022-04-24 Add narrow mounting holes
    [DifferentialEncoderSlave.kicad_pcb, DifferentialEncoderSlave.kicad_sch]
2022-04-24 Add RS485 termination resistor
    [DifferentialEncoderSlave.kicad_pcb, DifferentialEncoderSlave.kicad_sch]
2022-04-24 Ground CLIK-Mate shield pins
    [DifferentialEncoderSlave.kicad_pcb, DifferentialEncoderSlave.kicad_sch]
2022-04-25 Silkscreen fixes
    [DifferentialEncoderSlave.kicad_pcb]
